r0mzes/sim-wheel-gt300/stl/README.txt

Руль GT Ø300 (PCD 50.8) — STL для печати, версия v5 (под кожу, обод из половинок, канал Ø8)
Единицы: мм. Все детали уже повернуты для печати (плоской стороной на стол).

ДЕТАЛИ (13 шт.)
  rim_front_12h.stl           1 шт  — передняя половина, верх (без паза под спицу)
  rim_front_3h/6h/9h.stl      3 шт  — передние половины с пазом под язык спицы
  rim_back_1-30.stl           1 шт  — задняя половина 0…90° (паз спицы 3ч на конце)
  rim_back_4-30.stl           1 шт  — задняя половина 90…180° (пазы спиц 3ч и 6ч)
  rim_back_7-30.stl           1 шт  — задняя половина 180…270° (пазы 6ч и 9ч)
  rim_back_10-30.stl          1 шт  — задняя половина 270…360° (паз 9ч)
  spoke_3h/6h/9h.stl          3 шт  — спицы (одинаковые)
  hub_PCD50.8.stl             1 шт  — ступица-адаптер
  center_cap.stl              1 шт  — центральная крышка (вклеить)

Размер сегмента обода 210 × 60 × 14.5 мм — нужен стол ≥ 215 мм. Юбку/кайму (brim) не ставить или ставить минимальную.

НАСТРОЙКИ (PETG)
  Сопло 0.4, слой 0.16–0.2 (для обода — adaptive/variable layer height)
  Периметры 5–6, верх/низ 5–6 слоёв, заполнение 40–60 % гироид (ступица и спицы 80–100 %)
  Обод: без поддержек. Фаска 0.4 мм против «слоновьей ноги» уже есть в модели.
  Спицы: печать на ребре; включить поддержки только от стола (tree) — под суженной частью.
  Ступица, крышка: без поддержек.

ОТВЕРСТИЯ (заложены в модели)
  Стяжка половин: саморез 2.9×16 — цековка Ø6.2 / Ø3.4 в задней половине, пилот Ø2.5 в передней (16 шт.)
  Зажим спиц в ободе: M4×16 ISO 7380 — цековка Ø8.5 / Ø4.5, вставка M4×4 (гнездо Ø5.6×4) в передней половине (6 шт.)
  Спица → ступица: M4×12 ISO 7380 — цековка Ø8.5 / Ø4.5 в спице, вставка M4 (гнездо Ø5.6×6) в ступице (6 шт.)
  Ступица → база: 6× Ø5.5 на PCD 50.8 под M5; центр Ø20.
  Если вставки требуют другое отверстие, чем Ø5.6, — сообщите, пересоберу.

СБОРКА
  1. Вплавить вставки: 6 в ступицу, 6 в передние половины 3ч/6ч/9ч.
  2. Спицы прикрутить к ступице (M4×12).
  3. Согнуть трубку 8×1 в кольцо R137, соединить концы вставкой Ø6 на эпоксидке.
  4. Трубку уложить в канал передних половин, вставить языки спиц в пазы.
  5. Промазать плоскости разъёма эпоксидкой, наложить задние половины (стыки вразбежку),
     стянуть саморезами и винтами M4×16 через языки спиц.
  6. После отверждения — зашлифовать швы, обтянуть кожей.

====================================================================
АДАПТЕР НА ВАЛ Ø8 С ЛЫСКОЙ — shaft_adapter_D8.stl (1 шт.)
  Фланец Ø68×8 под ступицу (6× Ø5.5 на PCD 50.8, гнёзда под гайки M5 со стороны мотора),
  втулка Ø30×22, D-отверстие Ø8.2 / 7.6 по лыске, стяжной разрез + 2 винта M4,
  стопорный винт M4 в лыску (гайка вставляется в паз с торца втулки).
  Печать: фланцем на стол, втулка вверх. Без поддержек. PETG, 100 % заполнение
  (или 6–8 периметров + 60 % гироид), слой 0.2.

  Крепёж:
    6× винт M5×18 DIN 912 + 6× гайка M5 (ступица → адаптер; вместо M5×16 из прошлого списка)
    2× винт M4×16 DIN 912 + 2× гайка M4 (стяжка хомута)
    1× винт установочный M4×10 DIN 916 + 1× гайка M4 (стопор в лыску)

  Установка: надеть на вал до упора (вал 30 мм входит на 28 мм, торец вала в 2 мм от ступицы),
  затянуть стопорный винт в лыску, затем стяжные винты. Резьбовой фиксатор на стопорный винт.
  Через 1–2 часа езды подтянуть — PETG немного «садится».
