r0mzes/sim-wheel-gt300/docs/img/adapter_preview.png

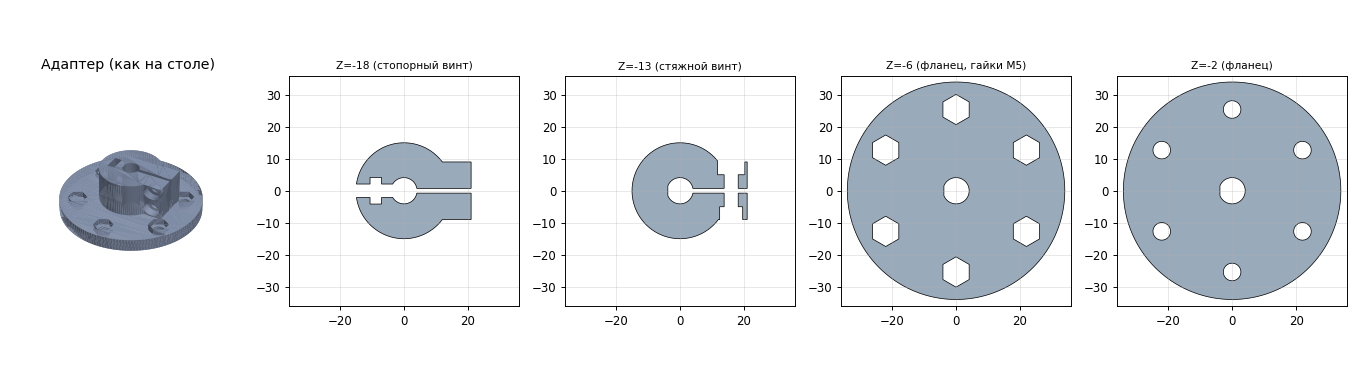
docs/img/adapter_preview.png
