r0mzes/sim-wheel-gt300/docs/img/plate_variantA.png

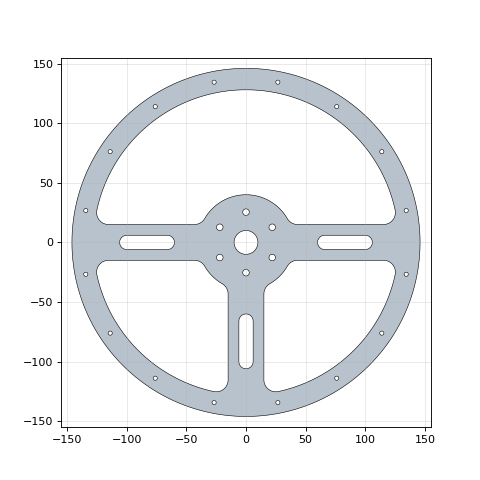
docs/img/plate_variantA.png
