r0mzes/sim-wheel-gt300/docs/img/stl_preview.png

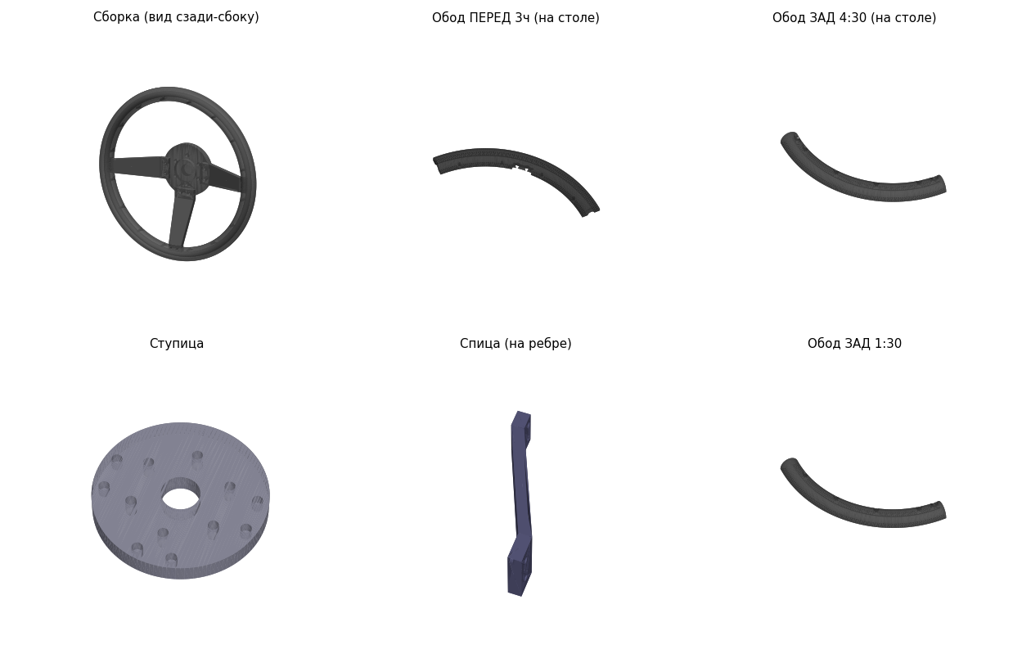
docs/img/stl_preview.png
