r0mzes/sim-wheel-gt300/docs/img/v6.png

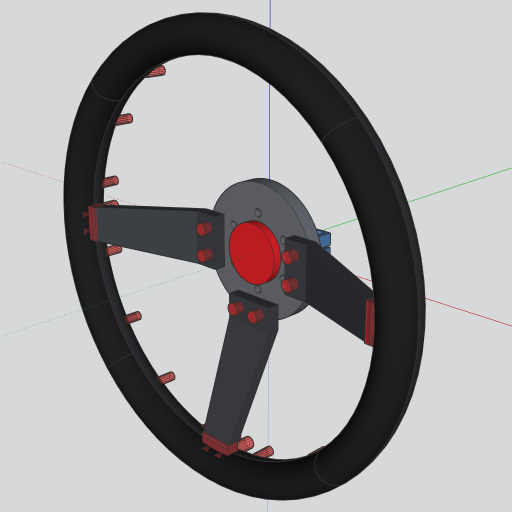
docs/img/v6.png
