r0mzes/sim-wheel-gt300/docs/img/v7.png

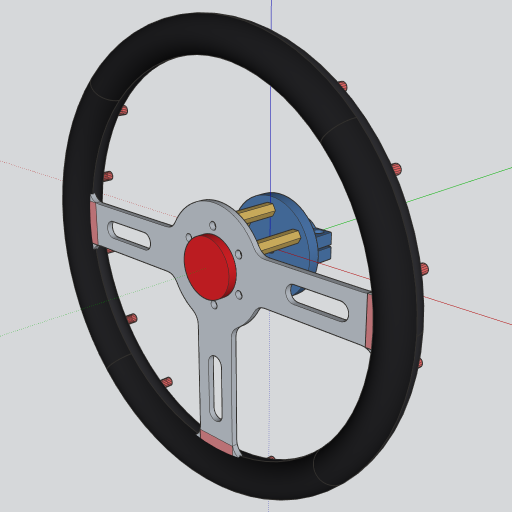
docs/img/v7.png
