r0mzes/sim-wheel-gt300/stl/hub_PCD50.8.stl

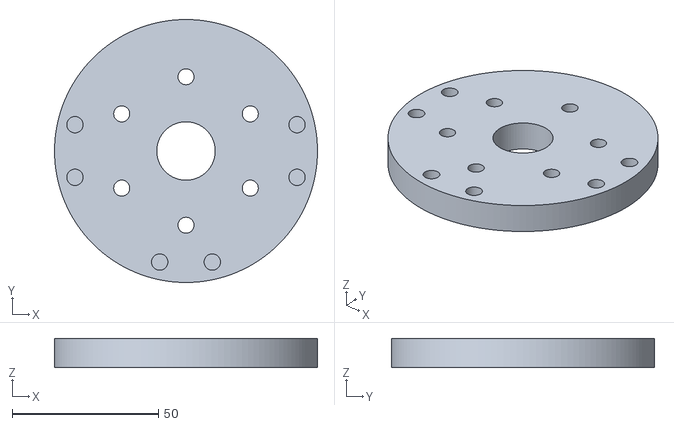
[picture p6: CAD file, 2026-10-17]
stl/hub_PCD50.8.stl
90.0 x 90.0 x 10.0
