r0mzes/sim-wheel-gt300/stl/rim_front_12h.stl

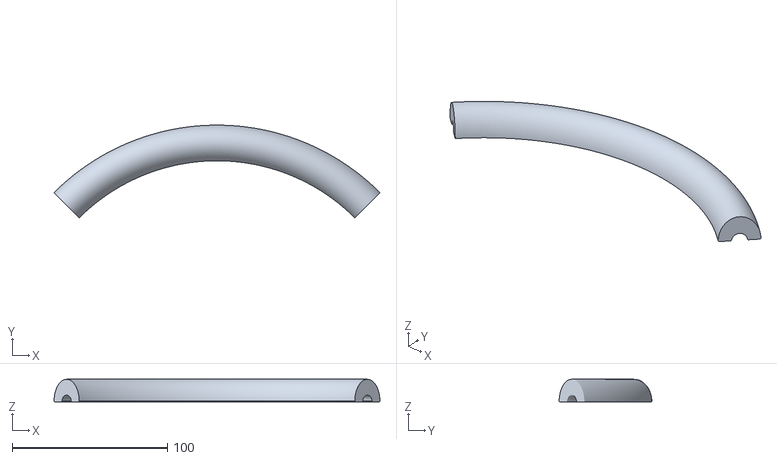
[picture p7: CAD file, 2026-10-17]
stl/rim_front_12h.stl
210.0 x 59.8 x 14.5
