r0mzes/sim-wheel-gt300/stl/rim_back_1-30.stl

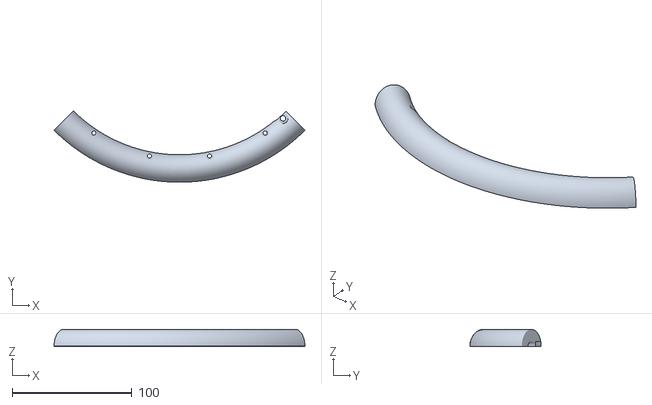
[picture p8: CAD file, 2026-10-17]
stl/rim_back_1-30.stl
210.0 x 59.8 x 14.5
