r0mzes/sim-wheel-gt300/stl/spoke_3h.stl

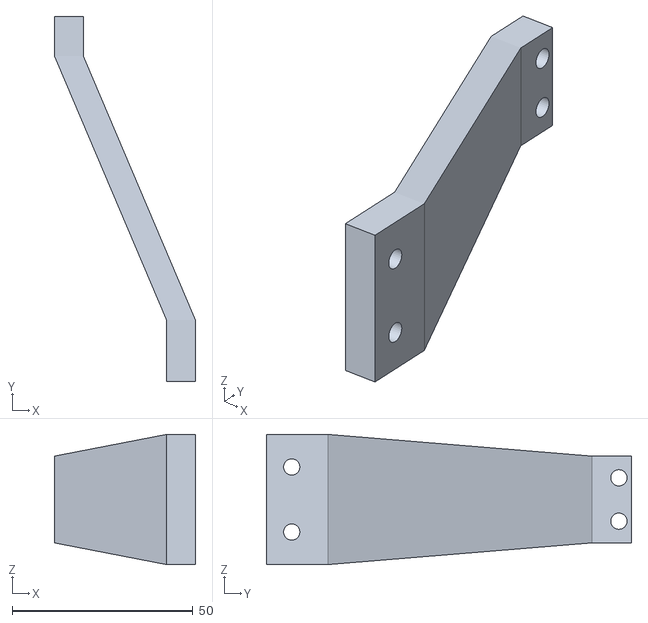
[picture p9: CAD file, 2026-10-17]
stl/spoke_3h.stl
39.0 x 101.0 x 36.0
