r0mzes/sim-wheel-gt300/stl/center_cap.stl

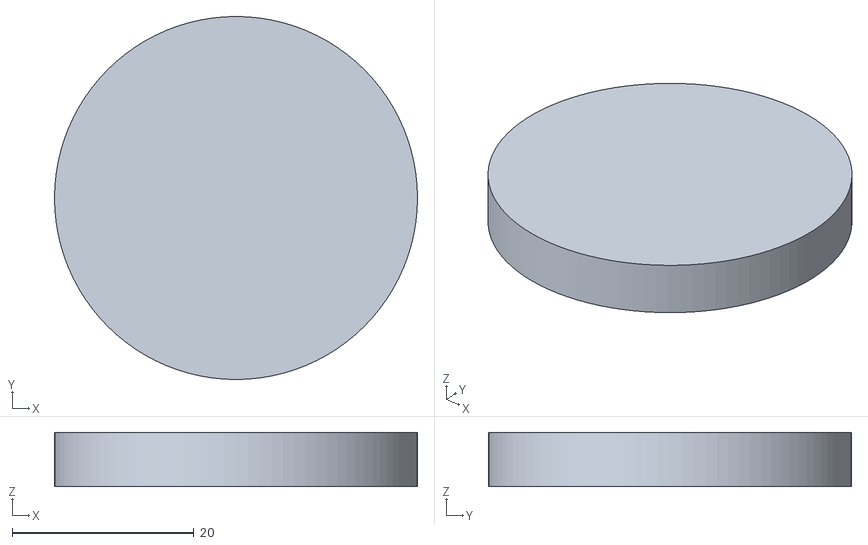
[picture p10: CAD file, 2026-10-17]
stl/center_cap.stl
40.0 x 40.0 x 6.00
