r0mzes/sim-wheel-gt300/stl/shaft_adapter_D8.stl

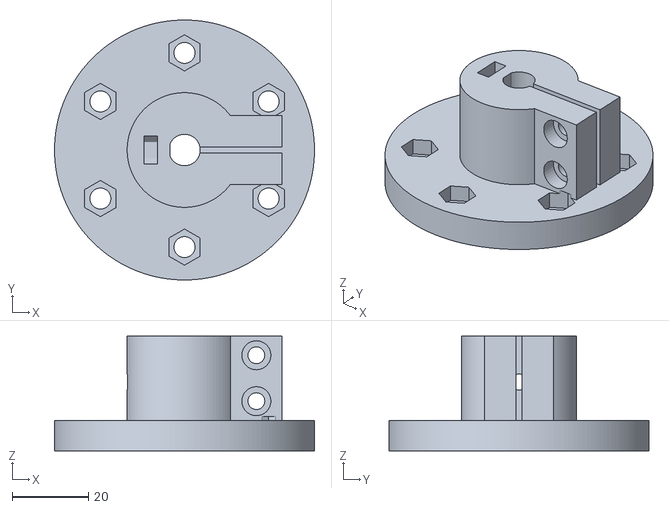
[picture p12: CAD file, 2026-10-17]
stl/shaft_adapter_D8.stl
68.0 x 68.0 x 30.0
