r0mzes/sim-wheel-gt300/(list of files, cad)

Other CAD files:
stl/rim_front_9h.stl
stl/rim_back_10-30.stl
stl/spoke_6h.stl
stl/spoke_9h.stl
stl/rim_front_6h.stl
stl/rim_back_4-30.stl
stl/rim_front_3h.stl
models/GT300_v1.skp
models/GT300_v2_lap-joints.skp
models/GT300_v4_halves-tube.skp
models/GT300_v5_leather.skp
models/GT300_v6_shaft-adapter.skp
models/GT300_v6_user-edit.skp
models/GT300_v7_variantA_Al-plate.skp
models/GT300_v8_variantB_steel-bar.skp
models/GT300_v9_horn-button_BLE.skp
