r0mzes/sim-wheel-gt300/(commit log)

2026-10-17 SketchUp models v1-v9
    [GT300_v1.skp, GT300_v2_lap-joints.skp, GT300_v4_halves-tube.skp, GT300_v5_leather.skp, GT300_v6_shaft-adapter.skp, GT300_v6_user-edit.skp, GT300_v7_variantA_Al-plate.skp, GT300_v8_variantB_steel-bar.skp]
2026-10-17 STL/outline generator scripts
2026-10-17 Geometry dumps from SketchUp (v6 user edit, v9 button)
2026-10-17 Printable STL (rim v5 halves, hub, spokes, shaft adapter)
    [center_cap.stl, hub_PCD50.8.stl, rim_back_1-30.stl, rim_back_10-30.stl, rim_back_4-30.stl, rim_back_7-30.stl, rim_front_12h.stl, rim_front_3h.stl]
